heitorneves91/rc/vehicle/cad/car.FCStd

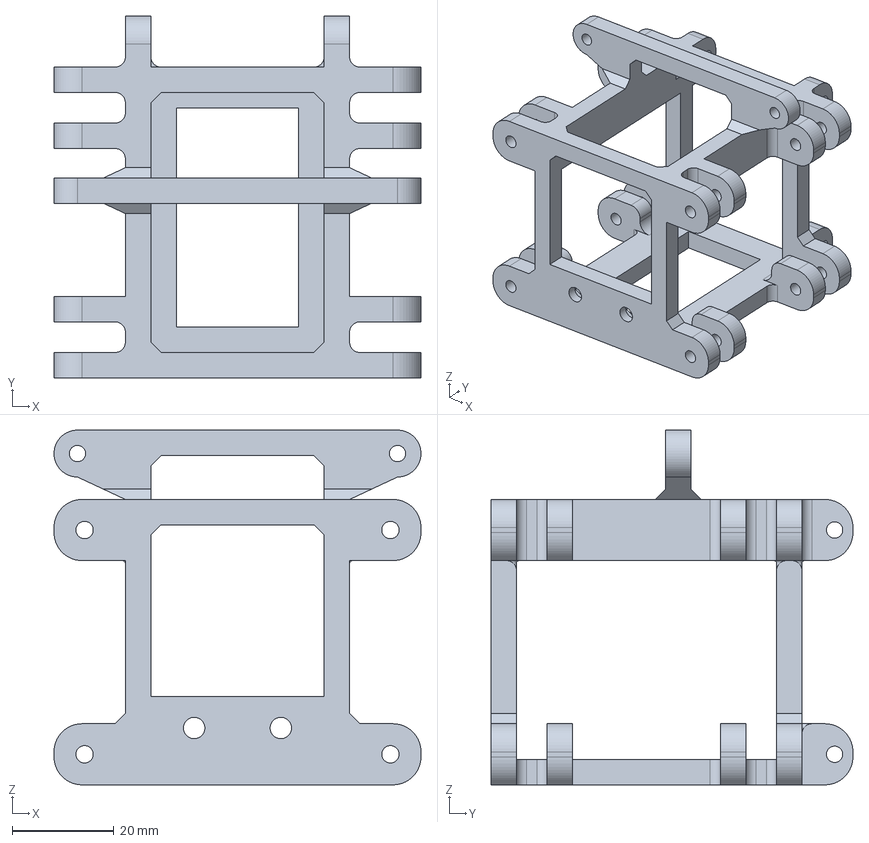
[picture p1: CAD file, 2026-11-07]
vehicle/cad/car.FCStd
72.0 x 71.0 x 69.6 mm
