heitorneves91/rc/(list of files, cad)

Other CAD files:
vehicle/cad/rear_assembly.FCStd
vehicle/cad/assembly.FCStd
vehicle/cad/base_project.3mf
