heitorneves91/rc/(commit log)

2026-08-28 electronics board schematic
2026-08-28 feat: migrate rpi to esp32
    [configuration.h]
2026-09-06 update camera service to MJPEG
    [configuration.h]
2026-10-27 rear ok!
    [car.FCStd]
2026-10-28 remove RearLeftModule
    [car.FCStd]
2026-11-02 electronics fixes
    [configuration.h]
2026-11-03 steering tuning and fix camera
    [ground_station_service.cpp, ground_station_service.h, movement_service.cpp, movement_service.h]
2026-11-04 bellcrank revolute joint
    [car.FCStd]
2026-11-05 improve steering and limit acceleration
2026-11-08 reduce max steering
